PontshoMbizo/js06-gantry-robot/docs/images/C4_uncertainty_envelope.png

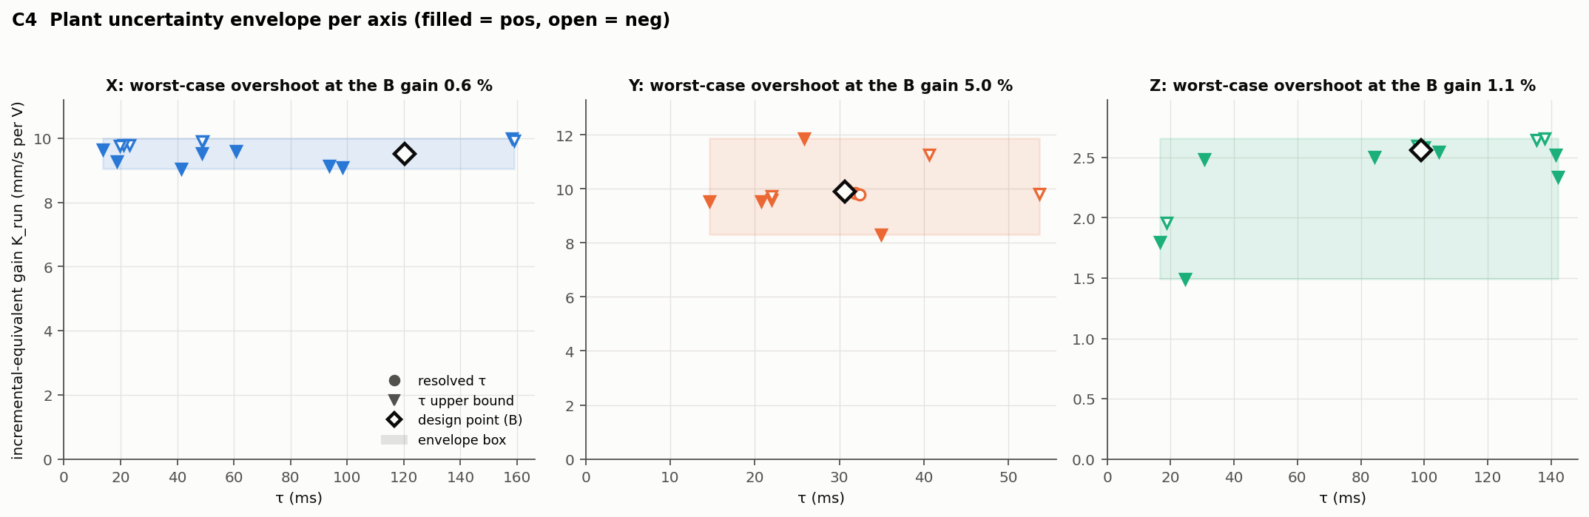
docs/images/C4_uncertainty_envelope.png
