PontshoMbizo/js06-gantry-robot/docs/images/gantry_built_photo.jpeg

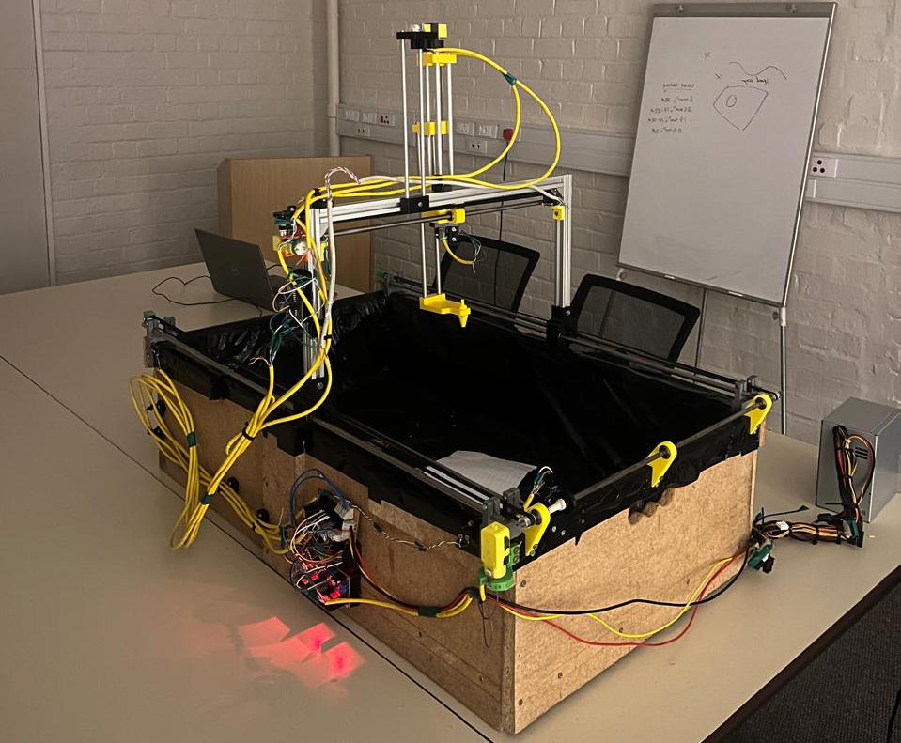
docs/images/gantry_built_photo.jpeg
