PontshoMbizo/js06-gantry-robot/docs/images/res_ctrl_settle.png

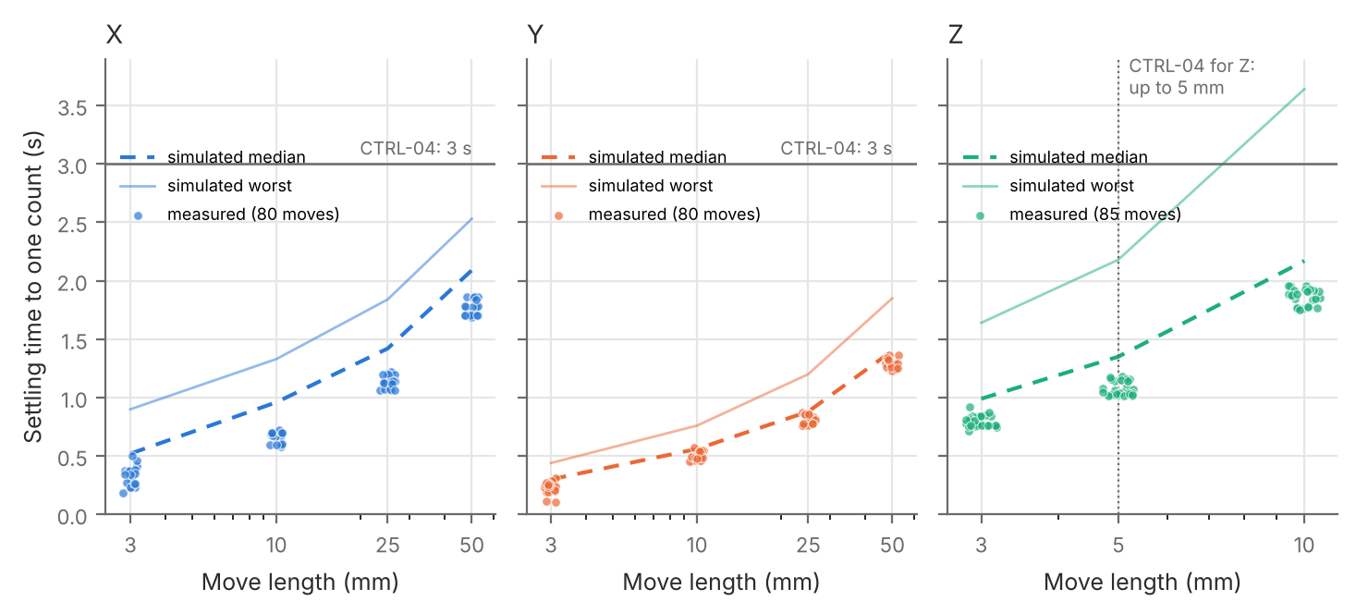
docs/images/res_ctrl_settle.png
