PontshoMbizo/js06-gantry-robot/simulation/ros2-digital-twin/src/main_gantry_assembly/meshes/__18.stl

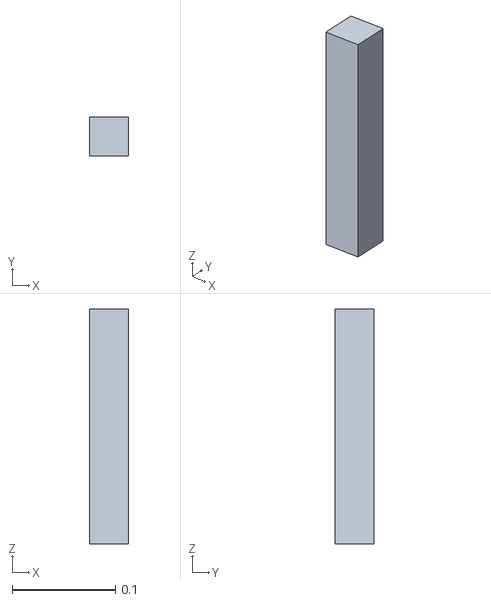
[picture p10: CAD file, 2026-11-06]
simulation/ros2-digital-twin/src/main_gantry_assembly/meshes/__18.stl
0.038 x 0.038 x 0.228
