PontshoMbizo/js06-gantry-robot/simulation/ros2-digital-twin/src/main_gantry_assembly/meshes/frame_holder.stl

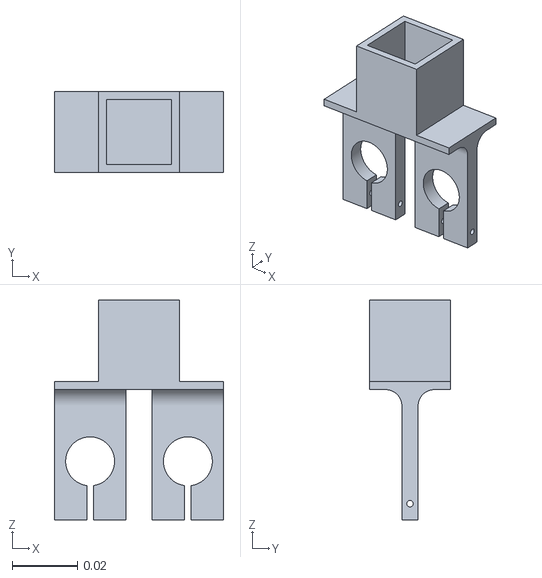
[picture p11: CAD file, 2026-11-06]
simulation/ros2-digital-twin/src/main_gantry_assembly/meshes/frame_holder.stl
0.052 x 0.025 x 0.0675
