PontshoMbizo/js06-gantry-robot/simulation/ros2-digital-twin/src/main_gantry_assembly/meshes/motor_holder.stl

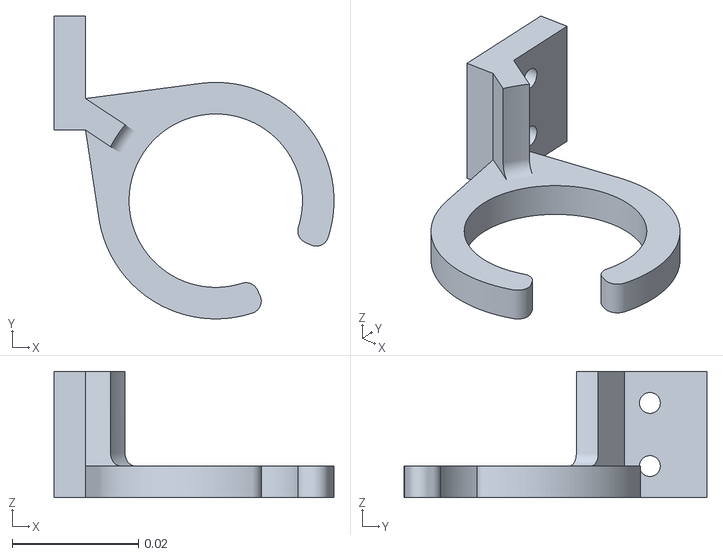
[picture p12: CAD file, 2026-11-06]
simulation/ros2-digital-twin/src/main_gantry_assembly/meshes/motor_holder.stl
0.0444 x 0.048 x 0.02
