PontshoMbizo/js06-gantry-robot/simulation/ros2-digital-twin/src/main_gantry_assembly/meshes/guide_holder_1.stl

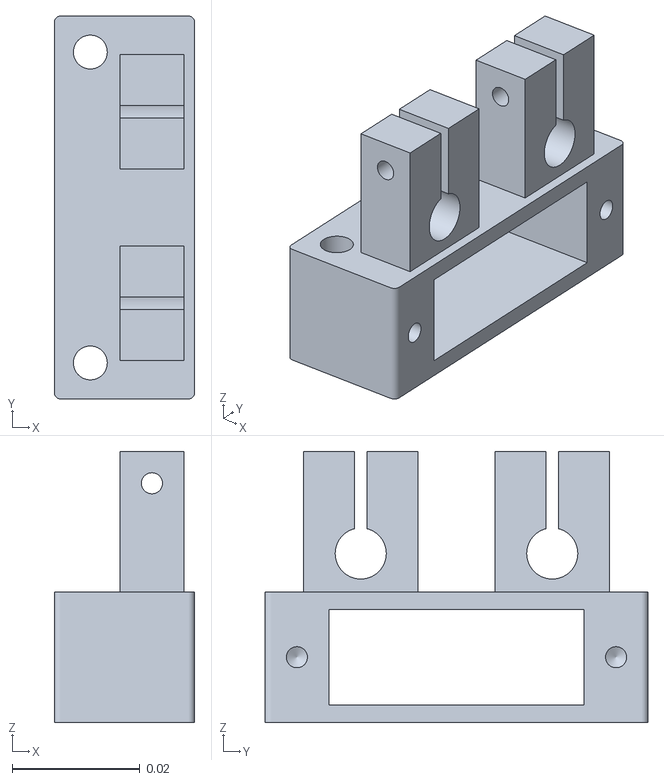
[picture p13: CAD file, 2026-11-06]
simulation/ros2-digital-twin/src/main_gantry_assembly/meshes/guide_holder_1.stl
0.022 x 0.06 x 0.0425
