PontshoMbizo/js06-gantry-robot/simulation/ros2-digital-twin/src/main_gantry_assembly/meshes/_8x1040_guide_rod.stl

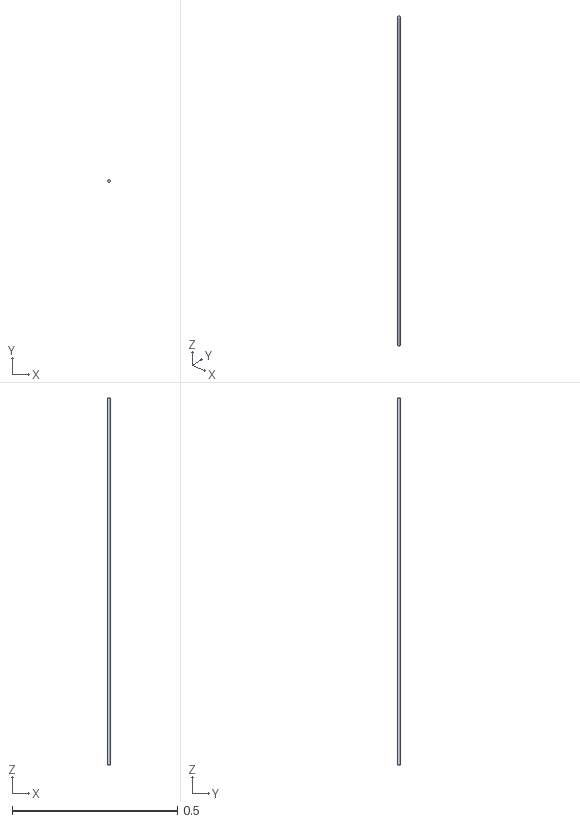
[picture p14: CAD file, 2026-11-06]
simulation/ros2-digital-twin/src/main_gantry_assembly/meshes/_8x1040_guide_rod.stl
0.008 x 0.008 x 1.11
