PontshoMbizo/js06-gantry-robot/simulation/ros2-digital-twin/src/main_gantry_assembly/meshes/shaft_extension.stl

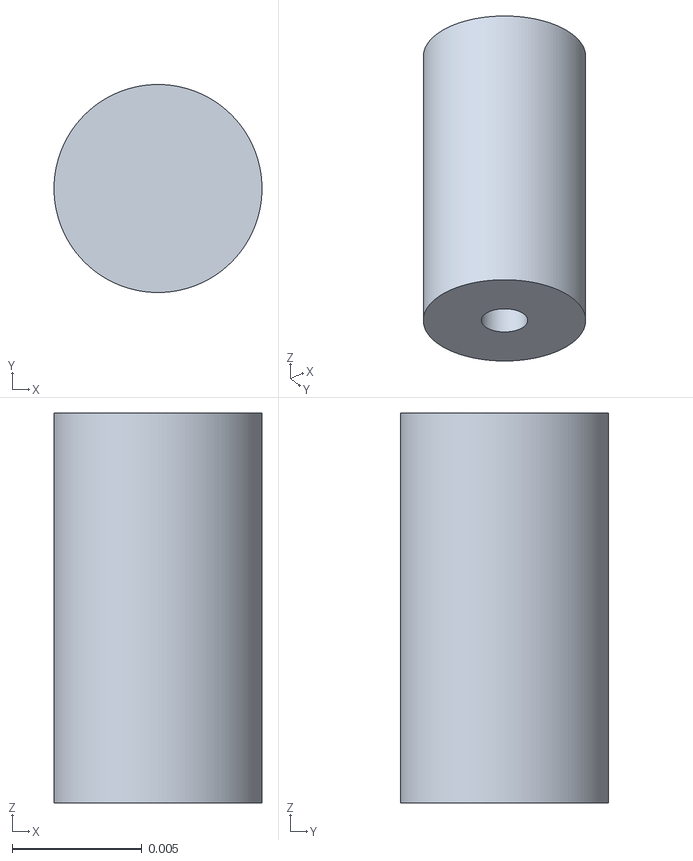
[picture p15: CAD file, 2026-11-06]
simulation/ros2-digital-twin/src/main_gantry_assembly/meshes/shaft_extension.stl
0.008 x 0.008 x 0.015
