PontshoMbizo/js06-gantry-robot/simulation/ros2-digital-twin/src/main_gantry_assembly/meshes/BokChoy__12_.stl

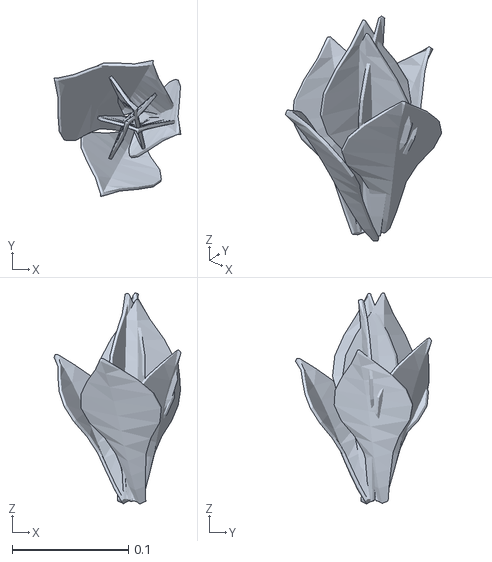
[picture p19: CAD file, 2026-11-06]
simulation/ros2-digital-twin/src/main_gantry_assembly/meshes/BokChoy__12_.stl
0.109 x 0.117 x 0.181
