PontshoMbizo/js06-gantry-robot/simulation/ros2-digital-twin/src/main_gantry_assembly/meshes/NICHIBO__MOTOR_BACK_01_Predeterminado__Fillet20.stl

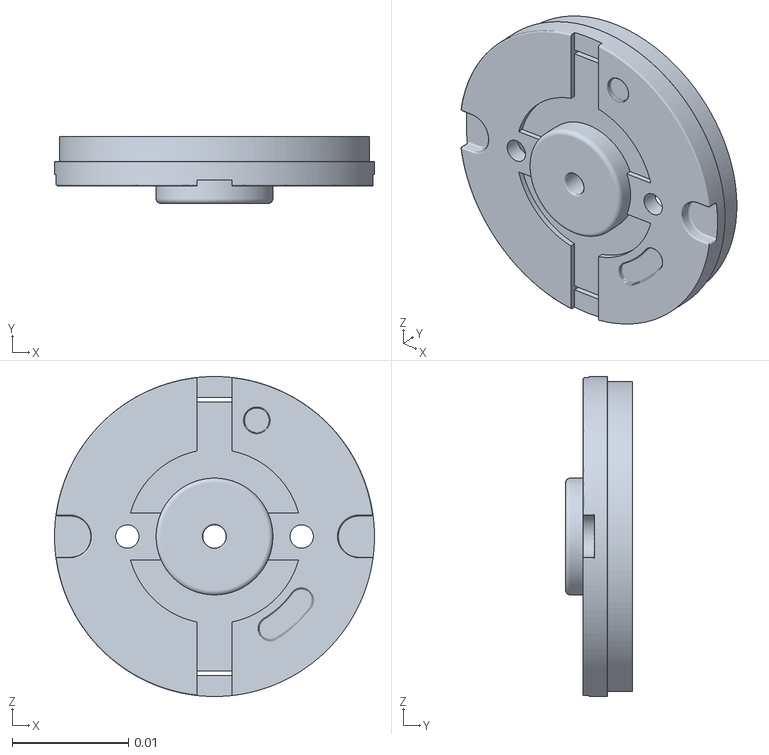
[picture p20: CAD file, 2026-11-06]
simulation/ros2-digital-twin/src/main_gantry_assembly/meshes/NICHIBO__MOTOR_BACK_01_Predeterminado__Fillet20.stl
0.0275 x 0.00574 x 0.0275
