PontshoMbizo/js06-gantry-robot/simulation/ros2-digital-twin/src/main_gantry_assembly/meshes/z_axis_end_piece.stl

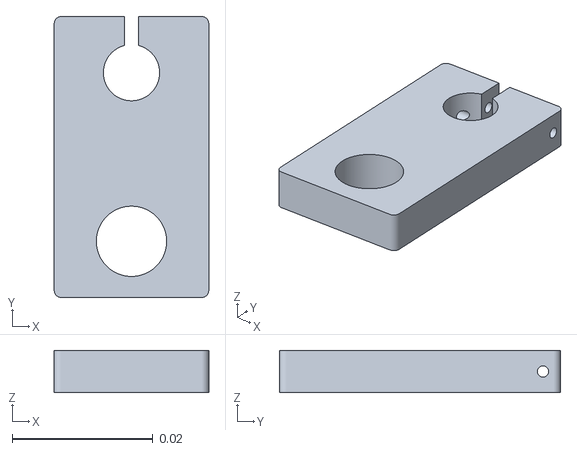
[picture p22: CAD file, 2026-11-06]
simulation/ros2-digital-twin/src/main_gantry_assembly/meshes/z_axis_end_piece.stl
0.022 x 0.04 x 0.006
