PontshoMbizo/js06-gantry-robot/simulation/ros2-digital-twin/src/main_gantry_assembly/meshes/COIL_01_Predeterminado__Fillet6.stl

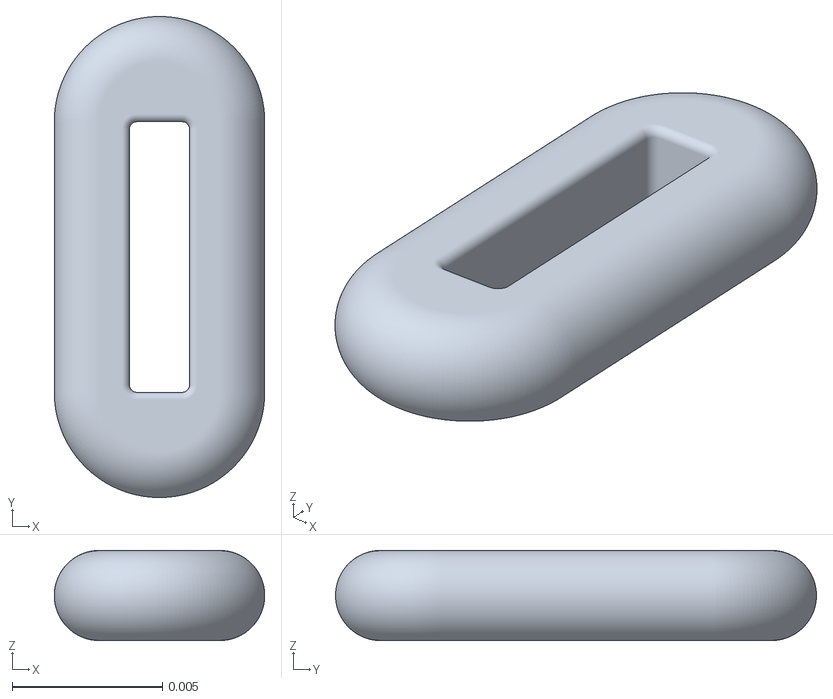
[picture p24: CAD file, 2026-11-06]
simulation/ros2-digital-twin/src/main_gantry_assembly/meshes/COIL_01_Predeterminado__Fillet6.stl
0.007 x 0.016 x 0.003
