PontshoMbizo/js06-gantry-robot/simulation/ros2-digital-twin/src/main_gantry_assembly/meshes/z_attachment.stl

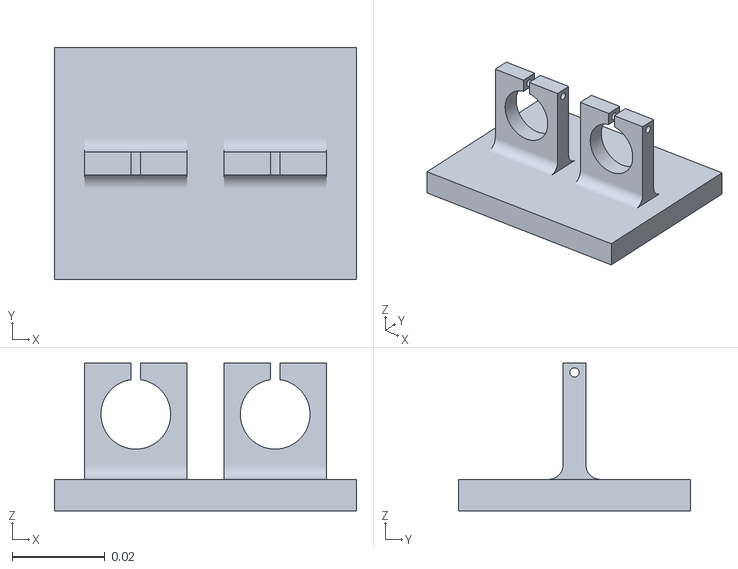
[picture p26: CAD file, 2026-11-06]
simulation/ros2-digital-twin/src/main_gantry_assembly/meshes/z_attachment.stl
0.065 x 0.05 x 0.0318
