PontshoMbizo/js06-gantry-robot/simulation/ros2-digital-twin/src/main_gantry_assembly/meshes/Lettuce__11_.stl

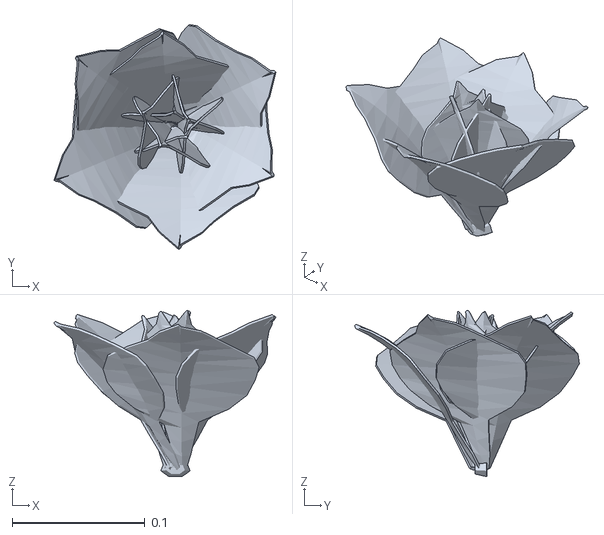
[picture p28: CAD file, 2026-11-06]
simulation/ros2-digital-twin/src/main_gantry_assembly/meshes/Lettuce__11_.stl
0.167 x 0.169 x 0.125
