PontshoMbizo/js06-gantry-robot/simulation/ros2-digital-twin/src/main_gantry_assembly/meshes/Default__SL_NZRCS3_2_8.stl

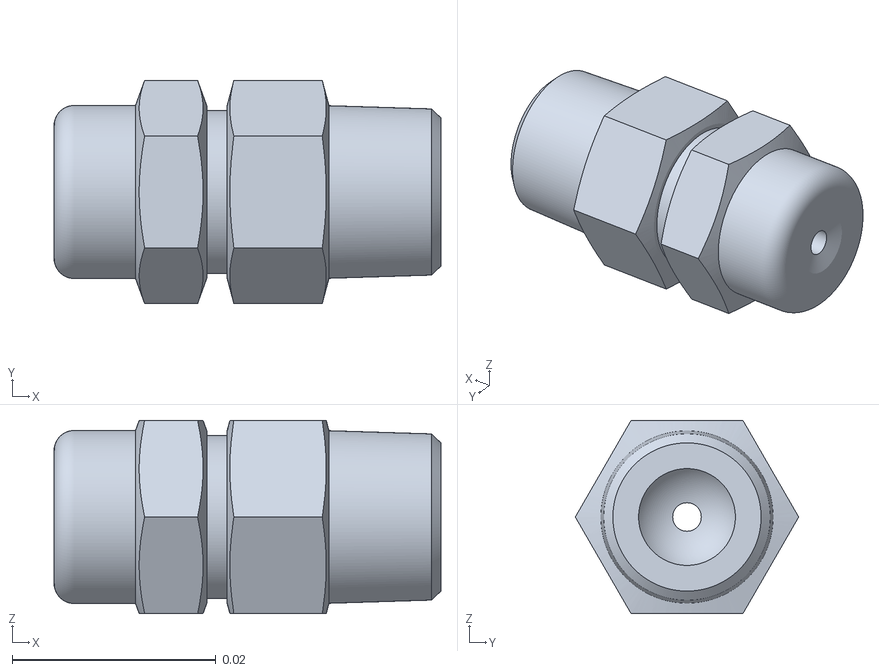
[picture p30: CAD file, 2026-11-06]
simulation/ros2-digital-twin/src/main_gantry_assembly/meshes/Default__SL_NZRCS3_2_8.stl
0.038 x 0.0219 x 0.019
