PontshoMbizo/js06-gantry-robot/simulation/ros2-digital-twin/src/main_gantry_assembly/meshes/gear_axis.stl

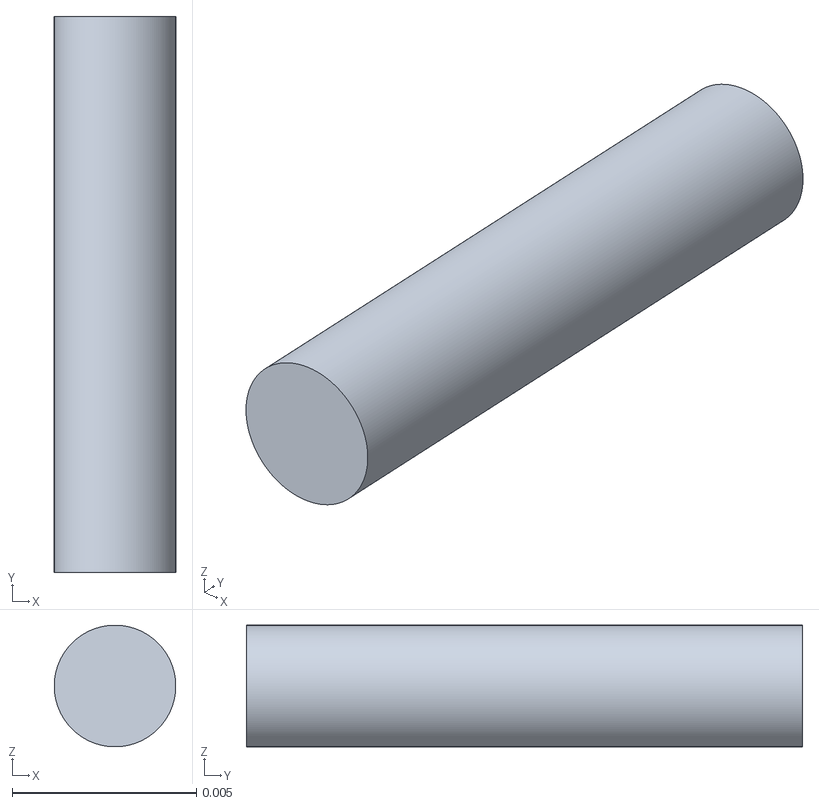
[picture p31: CAD file, 2026-11-06]
simulation/ros2-digital-twin/src/main_gantry_assembly/meshes/gear_axis.stl
0.0033 x 0.0151 x 0.0033
