PontshoMbizo/js06-gantry-robot/simulation/ros2-digital-twin/src/main_gantry_assembly/meshes/gear_idle_holder.stl

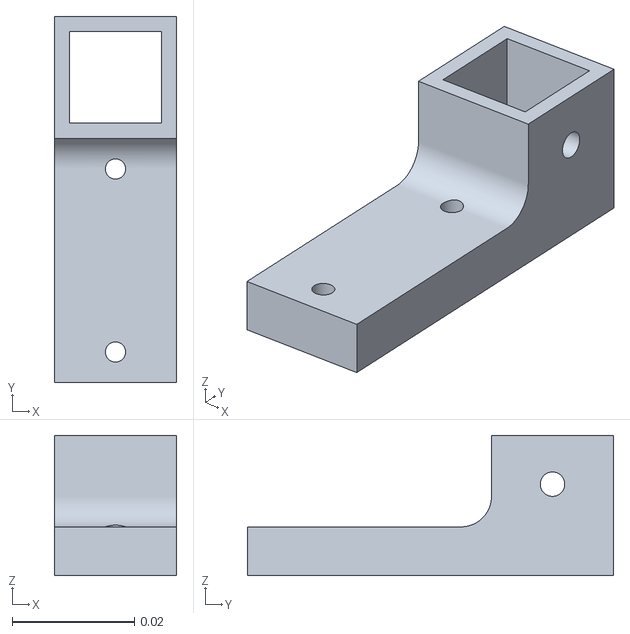
[picture p34: CAD file, 2026-11-06]
simulation/ros2-digital-twin/src/main_gantry_assembly/meshes/gear_idle_holder.stl
0.02 x 0.06 x 0.023
