PontshoMbizo/js06-gantry-robot/simulation/ros2-digital-twin/src/main_gantry_assembly/meshes/ARMATURE_NICHIBO_01_Predeterminado__Fillet5.stl

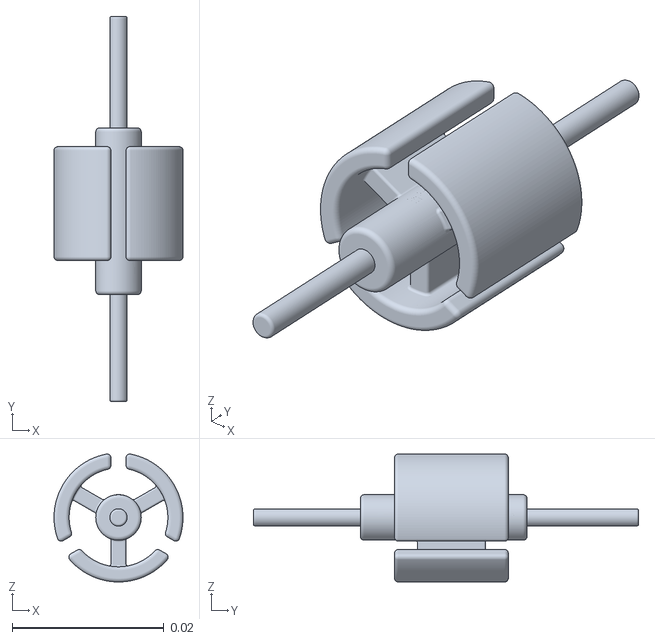
[picture p35: CAD file, 2026-11-06]
simulation/ros2-digital-twin/src/main_gantry_assembly/meshes/ARMATURE_NICHIBO_01_Predeterminado__Fillet5.stl
0.017 x 0.0508 x 0.0169
