PontshoMbizo/js06-gantry-robot/simulation/ros2-digital-twin/src/main_gantry_assembly/meshes/Radish__7_.stl

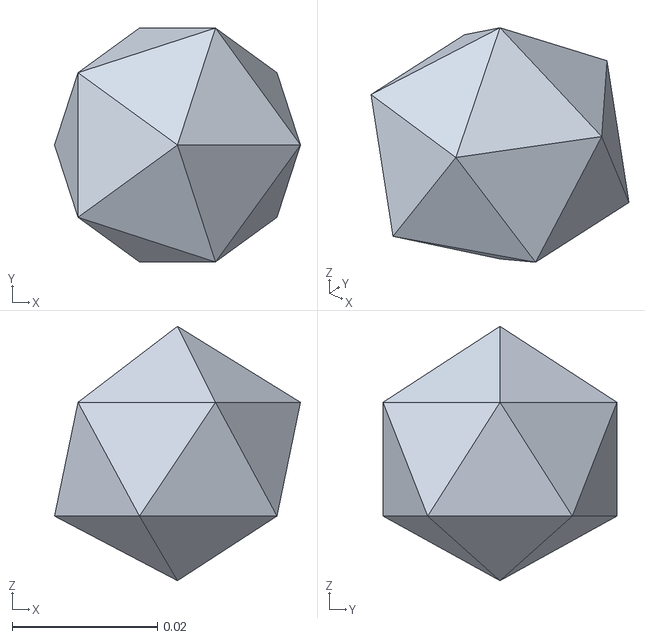
[picture p37: CAD file, 2026-11-06]
simulation/ros2-digital-twin/src/main_gantry_assembly/meshes/Radish__7_.stl
0.0339 x 0.0322 x 0.035
