PontshoMbizo/js06-gantry-robot/simulation/ros2-digital-twin/src/main_gantry_assembly/meshes/SoilCompartment.stl

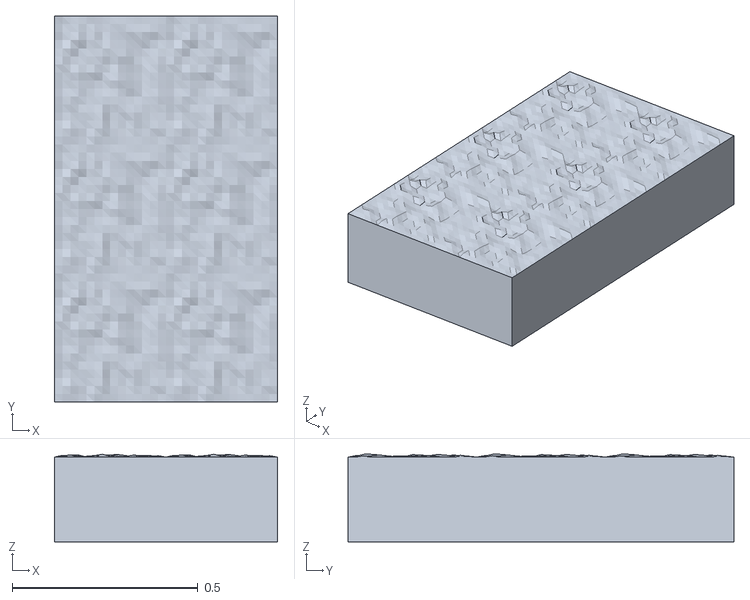
[picture p38: CAD file, 2026-11-06]
simulation/ros2-digital-twin/src/main_gantry_assembly/meshes/SoilCompartment.stl
0.6 x 1.04 x 0.236
