PontshoMbizo/js06-gantry-robot/simulation/ros2-digital-twin/src/main_gantry_assembly/meshes/NICHIBO_MOTOR_HOUSING_01_Predeterminado__Cut_Extrude10.stl

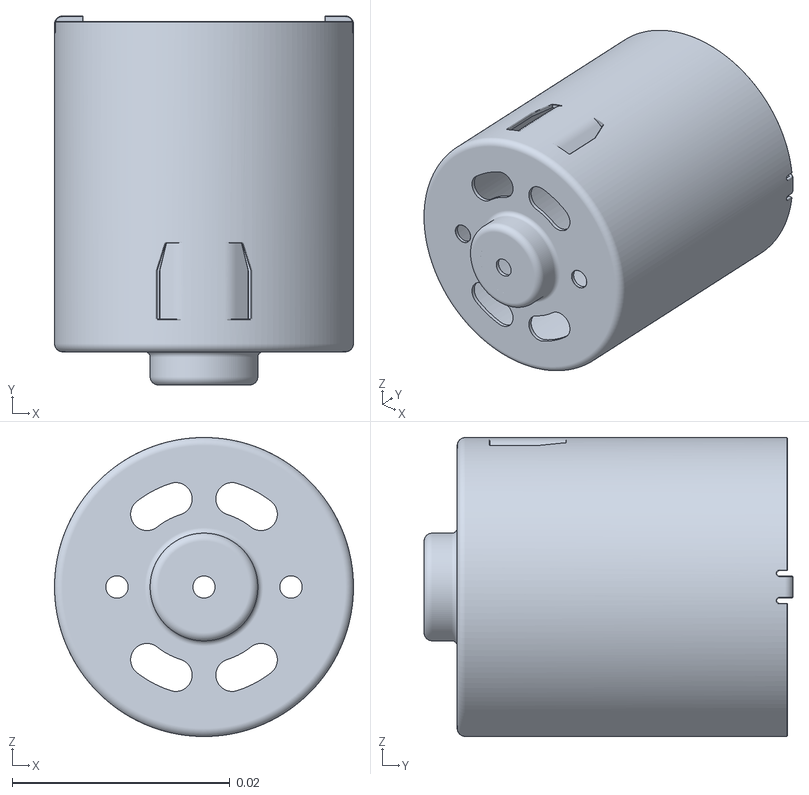
[picture p39: CAD file, 2026-11-06]
simulation/ros2-digital-twin/src/main_gantry_assembly/meshes/NICHIBO_MOTOR_HOUSING_01_Predeterminado__Cut_Extrude10.stl
0.0275 x 0.0339 x 0.0275
