PontshoMbizo/js06-gantry-robot/simulation/ros2-digital-twin/src/main_gantry_assembly/meshes/_618_5x8_tappered_3_85x4_coupling_rod.stl

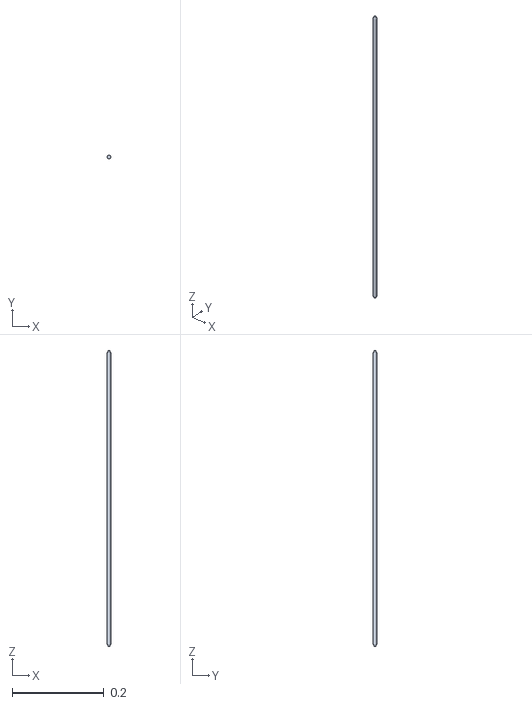
[picture p40: CAD file, 2026-11-06]
simulation/ros2-digital-twin/src/main_gantry_assembly/meshes/_618_5x8_tappered_3_85x4_coupling_rod.stl
0.008 x 0.008 x 0.644
