PontshoMbizo/js06-gantry-robot/simulation/ros2-digital-twin/src/main_gantry_assembly/meshes/nozzle_part.stl

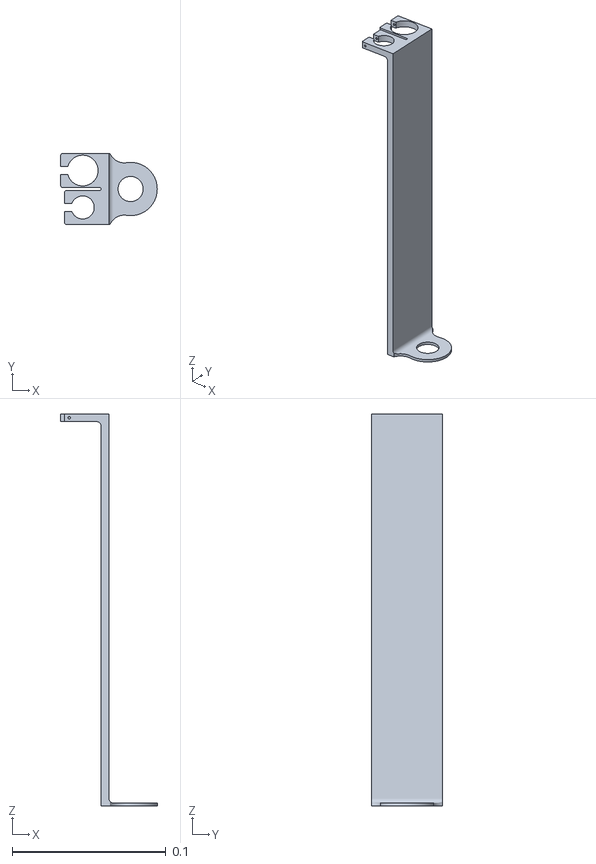
[picture p41: CAD file, 2026-11-06]
simulation/ros2-digital-twin/src/main_gantry_assembly/meshes/nozzle_part.stl
0.0628 x 0.046 x 0.255
