PontshoMbizo/js06-gantry-robot/simulation/ros2-digital-twin/src/main_gantry_assembly/meshes/_8x270_guide.stl

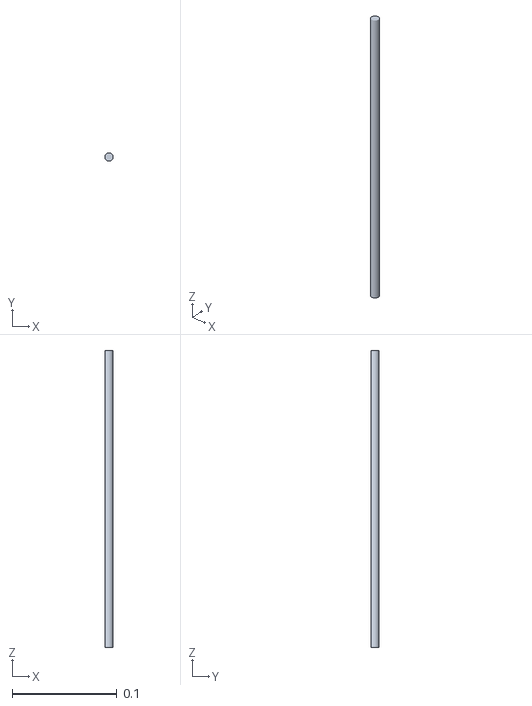
[picture p42: CAD file, 2026-11-06]
simulation/ros2-digital-twin/src/main_gantry_assembly/meshes/_8x270_guide.stl
0.008 x 0.008 x 0.284
