PontshoMbizo/js06-gantry-robot/simulation/ros2-digital-twin/src/main_gantry_assembly/meshes/control_box_lid.stl

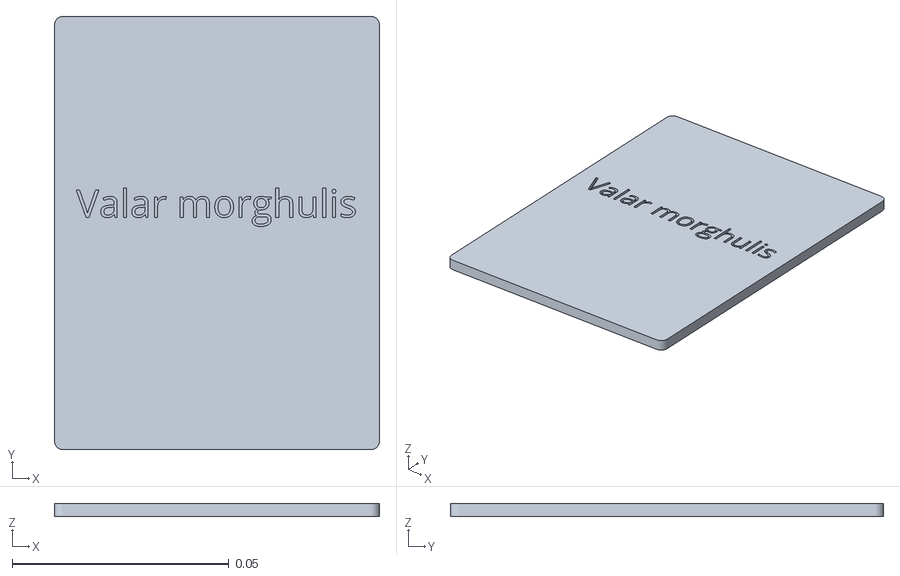
[picture p44: CAD file, 2026-11-06]
simulation/ros2-digital-twin/src/main_gantry_assembly/meshes/control_box_lid.stl
0.075 x 0.1 x 0.003
