PontshoMbizo/js06-gantry-robot/simulation/ros2-digital-twin/src/main_gantry_assembly/meshes/Terminal3V_Predeterminado__Fillet3.stl

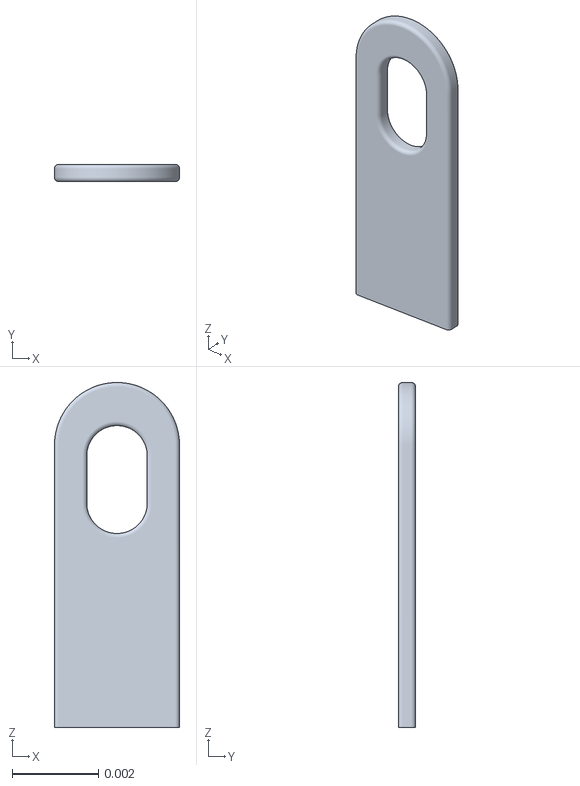
[picture p46: CAD file, 2026-11-06]
simulation/ros2-digital-twin/src/main_gantry_assembly/meshes/Terminal3V_Predeterminado__Fillet3.stl
0.0029 x 0.0004 x 0.008
