PontshoMbizo/js06-gantry-robot/simulation/ros2-digital-twin/src/main_gantry_assembly/meshes/gear_idler_holder.stl

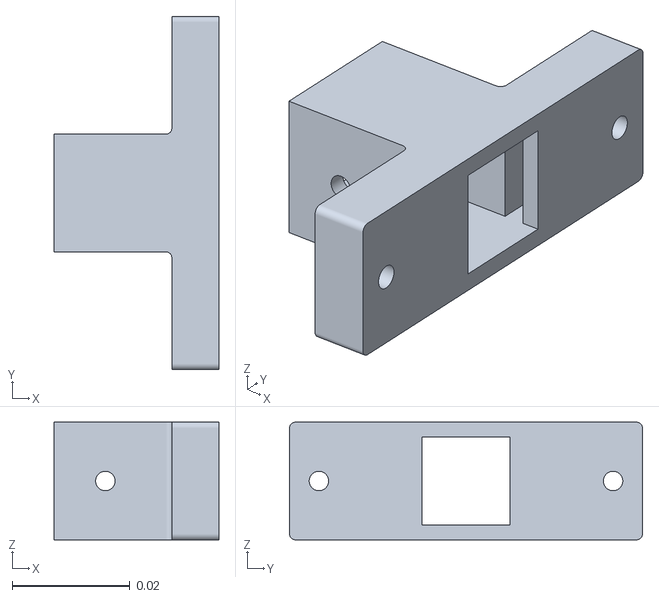
[picture p47: CAD file, 2026-11-06]
simulation/ros2-digital-twin/src/main_gantry_assembly/meshes/gear_idler_holder.stl
0.028 x 0.06 x 0.02
