PontshoMbizo/js06-gantry-robot/simulation/ros2-digital-twin/src/main_gantry_assembly/meshes/Default__SUTB106A4ZZ.stl

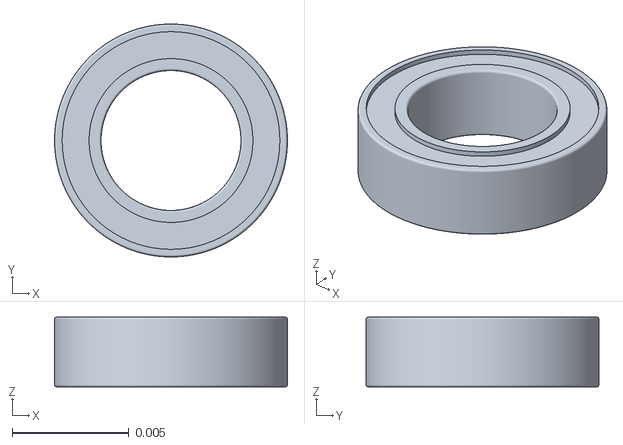
[picture p48: CAD file, 2026-11-06]
simulation/ros2-digital-twin/src/main_gantry_assembly/meshes/Default__SUTB106A4ZZ.stl
0.01 x 0.01 x 0.003
