PontshoMbizo/js06-gantry-robot/simulation/ros2-digital-twin/src/main_gantry_assembly/meshes/z_axis_motor_support.stl

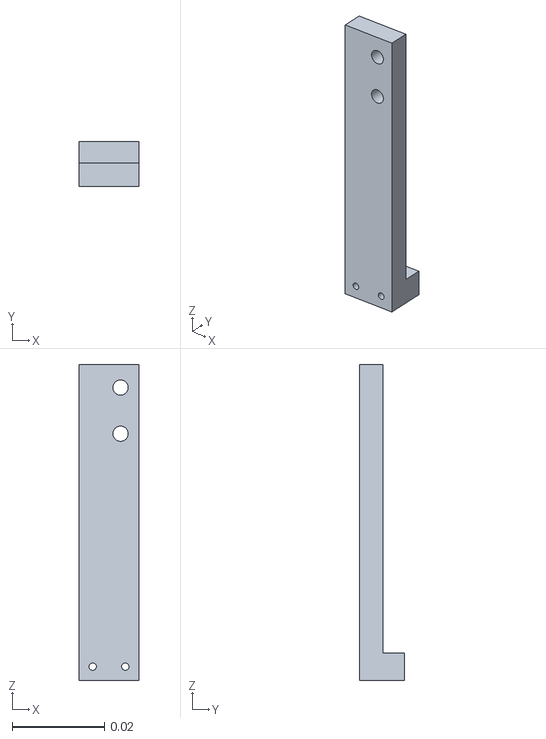
[picture p49: CAD file, 2026-11-06]
simulation/ros2-digital-twin/src/main_gantry_assembly/meshes/z_axis_motor_support.stl
0.0131 x 0.00965 x 0.0685
