PontshoMbizo/js06-gantry-robot/simulation/ros2-digital-twin/src/main_gantry_assembly/meshes/motor_bracket.stl

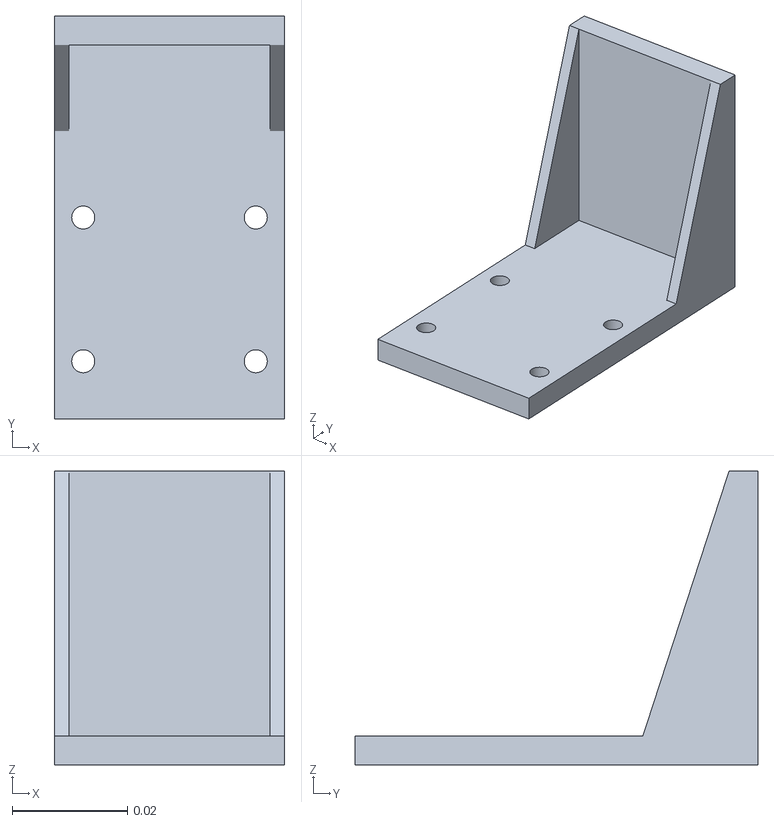
[picture p50: CAD file, 2026-11-06]
simulation/ros2-digital-twin/src/main_gantry_assembly/meshes/motor_bracket.stl
0.04 x 0.07 x 0.0511
