PontshoMbizo/js06-gantry-robot/simulation/ros2-digital-twin/src/main_gantry_assembly/meshes/Radish__4_.stl

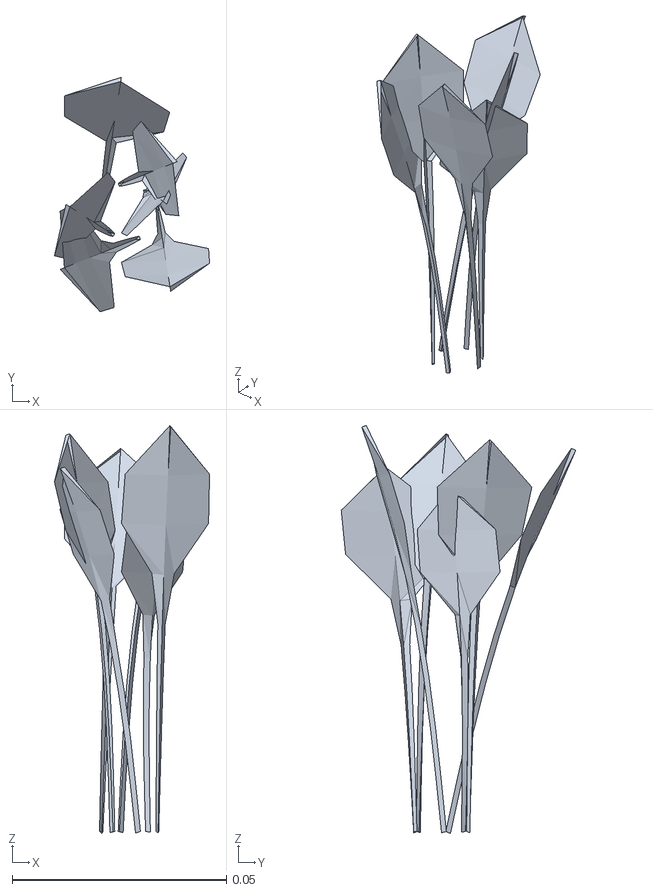
[picture p51: CAD file, 2026-11-06]
simulation/ros2-digital-twin/src/main_gantry_assembly/meshes/Radish__4_.stl
0.0362 x 0.0547 x 0.0951
