PontshoMbizo/js06-gantry-robot/simulation/ros2-digital-twin/src/main_gantry_assembly/meshes/Default__CPLCN20_8_8_b.stl

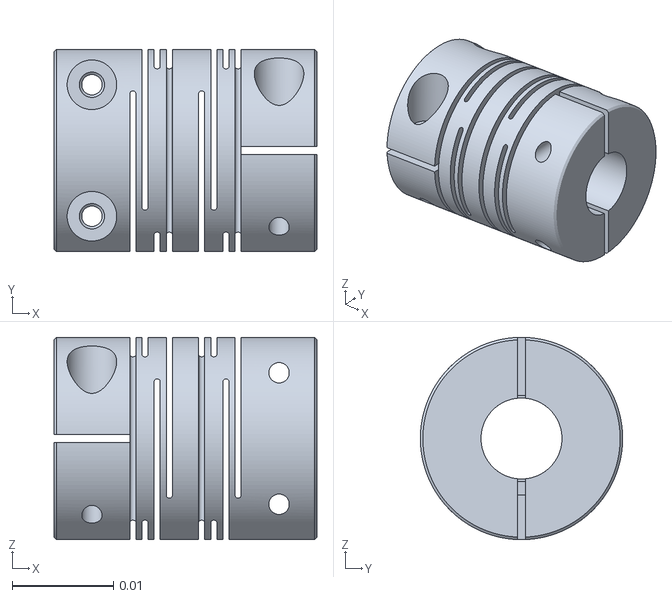
[picture p52: CAD file, 2026-11-06]
simulation/ros2-digital-twin/src/main_gantry_assembly/meshes/Default__CPLCN20_8_8_b.stl
0.026 x 0.02 x 0.02
