PontshoMbizo/js06-gantry-robot/(list of files, cad)

Other CAD files:
simulation/ros2-digital-twin/src/main_gantry_assembly/meshes/__1.stl
simulation/ros2-digital-twin/src/main_gantry_assembly/meshes/_.stl
simulation/ros2-digital-twin/src/main_gantry_assembly/meshes/__15.stl
simulation/ros2-digital-twin/src/main_gantry_assembly/meshes/__10.stl
simulation/ros2-digital-twin/src/main_gantry_assembly/meshes/__16.stl
simulation/ros2-digital-twin/src/main_gantry_assembly/meshes/__19.stl
simulation/ros2-digital-twin/src/main_gantry_assembly/meshes/__5.stl
simulation/ros2-digital-twin/src/main_gantry_assembly/meshes/__6.stl
simulation/ros2-digital-twin/src/main_gantry_assembly/meshes/__9.stl
simulation/ros2-digital-twin/src/main_gantry_assembly/meshes/__8.stl
simulation/ros2-digital-twin/src/main_gantry_assembly/meshes/__2.stl
simulation/ros2-digital-twin/src/main_gantry_assembly/meshes/__12.stl
simulation/ros2-digital-twin/src/main_gantry_assembly/meshes/__4.stl
simulation/ros2-digital-twin/src/main_gantry_assembly/meshes/__11.stl
simulation/ros2-digital-twin/src/main_gantry_assembly/meshes/__17.stl
simulation/ros2-digital-twin/src/main_gantry_assembly/meshes/_8x270x1_5_lead_screw.stl
