PontshoMbizo/js06-gantry-robot/simulation/ros2-digital-twin/src/main_gantry_assembly/urdf/main_assembly.urdf

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
<robot name="main_assembly">
    <link name="618_5x8_tappered_3_85x4_coupling_rod">
        <inertial>
            <mass value="3.20656e-05" />
            <origin xyz="0 -1.22095e-19 -0.32185" rpy="0 -0 0" />
            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
        </inertial>
        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
    </link>
    <link name="8x1040_guide_rod">
        <inertial>
            <mass value="5.57444e-05" />
            <origin xyz="2.77556e-17 -1.92593e-34 -0.5545" rpy="0 -0 0" />
            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
        </inertial>
        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
    </link>
    <link name="8x1040_guide_rod_1">
        <inertial>
            <mass value="5.57444e-05" />
            <origin xyz="2.77556e-17 -1.44445e-34 0.5545" rpy="0 -0 0" />
            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
        </inertial>
        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
    </link>
    <link name="8x1040_guide_rod_2">
        <inertial>
            <mass value="5.57444e-05" />
            <origin xyz="2.77556e-17 -1.92593e-34 -0.5545" rpy="0 -0 0" />
            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
        </inertial>
        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
    </link>
    <link name="8x1040_guide_rod_3">
        <inertial>
            <mass value="5.57444e-05" />
            <origin xyz="2.77556e-17 -1.44445e-34 0.5545" rpy="0 -0 0" />
            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
        </inertial>
        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
    </link>
    <link name="8x270_guide">
        <inertial>
            <mass value="1.42754e-05" />
            <origin xyz="1.85336e-19 -1.44445e-34 0.142" rpy="0 -0 0" />
            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
        </inertial>
        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
    </link>
    <link name="8x270x1_5_lead_screw">
        <inertial>
            <mass value="2.32164e-05" />
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
        </inertial>
        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
    </link>
    <link name="default__cplcn20_8_8_b">
        <inertial>
            <mass value="0.00640527" />
            <origin xyz="0.0013 -0.00015552 -0.00015552" rpy="0 -0 0" />
            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
        </inertial>
        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
    </link>
    <link name="default__cplcn20_8_8_b_1">
        <inertial>
            <mass value="0.00640527" />
            <origin xyz="0.0019 -0.00015552 -0.00015552" rpy="0 -0 0" />
            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
        </inertial>
        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
    </link>
    <link name="default__cplcn20_8_8_b_2">
        <inertial>
            <mass value="0.00640527" />
            <origin xyz="-0.013 -0.00015552 -0.00015552" rpy="0 -0 0" />
            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
        </inertial>
        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
    </link>
    <link name="default__sl_nzrcs3_2_8">
        <inertial>
            <mass value="6.70002e-06" />
            <origin xyz="0.00110206 -3.10162e-18 -2.71322e-19" rpy="0 -0 0" />
            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
        </inertial>
        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
    </link>
    <link name="default__sutb106a4zz">
        <inertial>
            <mass value="1.38701e-07" />
            <origin xyz="1.95262e-19 2.38551e-19 -0.0014" rpy="0 -0 0" />
            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
        </inertial>
        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
    </link>
    <link name="default__sutb106a4zz_1">
        <inertial>
            <mass value="1.38701e-07" />
            <origin xyz="1.95262e-19 2.38551e-19 -0.0014" rpy="0 -0 0" />
            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
        </inertial>
        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
    </link>
    <link name="dof_lead_nut" />
    <link name="fix_end_piece" />
    <link name="fix_end_piece_1" />
    <link name="fix_end_piece_2" />
    <link name="fix_support" />
    <link name="fix_support_1" />
    <link name="fix_support_2" />
    <link name="frame_holder">
        <inertial>
            <mass value="0.0213048" />
            <origin xyz="-0.015 -6.93889e-18 0.0200196" rpy="0 -0 0" />
            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
        </inertial>
        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
    </link>
    <link name="frame_holder_1">
        <inertial>
            <mass value="0.0213048" />
            <origin xyz="-0.015 -6.93889e-18 0.0200196" rpy="0 -0 0" />
            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
        </inertial>
        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
    </link>
    <link name="frame_holder__1__loop_closure">
        <inertial>
            <mass value="1e-09" />
            <origin xyz="0 0 0" rpy="0 -0 0" />
            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
        </inertial>
    </link>
    <link name="gear_axis">
        <inertial>
            <mass value="1.2915e-07" />
            <origin xyz="1.66533e-16 0.00755 -1.73472e-18" rpy="0 -0 0" />
            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
        </inertial>
        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
    </link>
    <link name="gear_axis_1">
        <inertial>
            <mass value="1.2915e-07" />
            <origin xyz="1.66533e-16 0.00755 -3.46945e-18" rpy="0 -0 0" />
            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
        </inertial>
        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
    </link>
    <link name="gear_idle_holder">
        <inertial>
            <mass value="0.0129154" />
            <origin xyz="-1.1938e-14 0.0316998 0.00690779" rpy="0 -0 0" />
            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
        </inertial>
        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
    </link>
    <link name="gear_idle_holder_1">
        <inertial>
            <mass value="0.0129154" />
            <origin xyz="-1.19258e-14 -0.00330017 0.00690779" rpy="0 -0 0" />
            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
        </inertial>
        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
    </link>
    <link name="gear_idle_holder_2">
        <inertial>
            <mass value="0.0129154" />
            <origin xyz="-1.1938e-14 0.0316998 0.00690779" rpy="0 -0 0" />
            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
        </inertial>
        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
    </link>
    <link name="gear_idle_holder_3">
        <inertial>
            <mass value="0.0129154" />
            <origin xyz="-1.19258e-14 -0.00330017 0.00690779" rpy="0 -0 0" />
            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
        </inertial>
        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
    </link>
    <link name="gear_idler_holder">
        <inertial>
            <mass value="0.0117168" />
            <origin xyz="-0.00916163 0.025 0" rpy="0 -0 0" />
            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
        </inertial>
        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
    </link>
    <link name="gear_idler_holder_1">
        <inertial>
            <mass value="0.0117168" />
            <origin xyz="-0.00916163 0.025 0" rpy="0 -0 0" />
            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
        </inertial>
        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
    </link>
    <link name="guide_holder">
        <inertial>
            <mass value="0.0241753" />
            <origin xyz="2.77556e-17 0.01 0.00522515" rpy="0 -0 0" />
            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
        </inertial>
        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
    </link>
    <link name="guide_holder_1">
        <inertial>
            <mass value="0.0241753" />
            <origin xyz="0.015 0.004 -0.00977485" rpy="0 -0 0" />
            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
        </inertial>
        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
    </link>
    <link name="guide_holder_2">
        <inertial>
            <mass value="0.0235401" />
            <origin xyz="0.00697448 0.02435 0.0172525" rpy="0 -0 0" />
            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
        </inertial>
        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
    </link>
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
        <inertial>
            <mass value="5.95257e-05" />
            <origin xyz="1.9581e-19 -5.40965e-20 0.00353066" rpy="0 -0 0" />
            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
        </inertial>
        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
    </link>
    <link name="terminal3v_predeterminado__fillet3_2">
        <inertial>
            <mass value="5.95257e-05" />
            <origin xyz="1.9581e-19 -5.40965e-20 0.00353066" rpy="0 -0 0" />
            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
        </inertial>
        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
    </link>
    <link name="terminal3v_predeterminado__fillet3_3">
        <inertial>
            <mass value="5.95257e-05" />
            <origin xyz="1.9581e-19 -5.40965e-20 0.00353066" rpy="0 -0 0" />
            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
        </inertial>
        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
    </link>
    <link name="terminal3v_predeterminado__fillet3_4">
        <inertial>
            <mass value="5.95257e-05" />
            <origin xyz="1.9581e-19 -5.40965e-20 0.00353066" rpy="0 -0 0" />
            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
        </inertial>
        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
    </link>
    <link name="terminal3v_predeterminado__fillet3_5">
        <inertial>
            <mass value="5.95257e-05" />
            <origin xyz="1.9581e-19 -5.40965e-20 0.00353066" rpy="0 -0 0" />
            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
        </inertial>
        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
    </link>
    <link name="terminal3v_predeterminado__fillet3__2__loop_closure">
        <inertial>
            <mass value="1e-09" />
            <origin xyz="0 0 0" rpy="0 -0 0" />
            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
        </inertial>
    </link>
    <link name="x_carriage__1_" />
    <link name="y_carriage__1_" />
    <link name="z_attachment">
        <inertial>
            <mass value="0.0322584" />
            <origin xyz="0.015 -8.81456e-20 -0.0153773" rpy="0 -0 0" />
            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
        </inertial>
        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
    </link>
    <link name="z_axis_carriage_piece__1_" />
    <link name="z_axis_end_piece">
        <inertial>
            <mass value="0.00547166" />
            <origin xyz="-0.0109471 0.000176597 5.5544e-06" rpy="0 -0 0" />
            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
        </inertial>
        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
    </link>
    <link name="z_axis_end_piece_1">
        <inertial>
            <mass value="0.00547166" />
            <origin xyz="5.29383e-05 -0.0119791 -0.00299445" rpy="0 -0 0" />
            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
        </inertial>
        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
    </link>
    <link name="z_axis_end_piece__1__loop_closure">
        <inertial>
            <mass value="1e-09" />
            <origin xyz="0 0 0" rpy="0 -0 0" />
            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
        </inertial>
    </link>
    <link name="z_axis_motor_support">
        <inertial>
            <mass value="4.71205e-06" />
            <origin xyz="-0.0227639 -0.0177915 -0.0368325" rpy="0 -0 0" />
            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
        </inertial>
        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
    </link>
    <joint name="bok_choy__3__fastened_joint" type="fixed">
        <origin xyz="0 0 0" rpy="0 0 -8.95218e-100" />
        <axis xyz="0 0 1" />
        <parent link="bokchoy__12__5" />
        <child link="composite_part_1__15_" />
    </joint>
    <joint name="bok_choy__3__fastened_joint_1" type="fixed">
        <origin xyz="0 -0.16 -5.55112e-17" rpy="0 0 -8.95218e-100" />
        <axis xyz="-0 -0 -1" />
        <parent link="bokchoy__12_" />
        <child link="bokchoy__12__1" />
    </joint>
    <joint name="bok_choy__3__fastened_joint_2" type="fixed">
        <origin xyz="1.11022e-16 -0.16 0" rpy="0 0 -8.95218e-100" />
        <axis xyz="0 0 1" />
        <parent link="bokchoy__12__5" />
        <child link="composite_part_1__16_" />
    </joint>
    <joint name="bok_choy__3__fastened_joint_3" type="fixed">
        <origin xyz="1.11022e-16 -0.48 -5.55112e-17" rpy="0 0 -8.95218e-100" />
        <axis xyz="-0 -0 -1" />
        <parent link="bokchoy__12_" />
        <child link="bokchoy__12__4" />
    </joint>
    <joint name="bok_choy__3__fastened_joint_4" type="fixed">
        <origin xyz="0 0 0" rpy="0 0 -8.95218e-100" />
        <axis xyz="-0 -0 -1" />
        <parent link="bokchoy__12_" />
        <child link="composite_part_2__3_" />
    </joint>
    <joint name="bok_choy__3__fastened_joint_5" type="fixed">
        <origin xyz="0 0.16 0" rpy="0 0 -8.95218e-100" />
        <axis xyz="0 0 1" />
        <parent link="bokchoy__12__5" />
        <child link="composite_part_1__9_" />
    </joint>
    <joint name="bok_choy__3__fastened_joint_6" type="fixed">
        <origin xyz="0 0.32 5.55112e-17" rpy="0 0 -8.95218e-100" />
        <axis xyz="0 0 1" />
        <parent link="bokchoy__12__5" />
        <child link="bokchoy__12_" />
    </joint>
    <joint name="bok_choy__3__fastened_joint_loop_closure" type="fixed">
        <origin xyz="-1.11022e-16 0.32 0" rpy="0 0 -8.95218e-100" />
        <axis xyz="-0 -0 -1" />
        <parent link="composite_part_1__16_" />
        <child link="composite_part_2__6__loop_closure" />
    </joint>
    <joint name="bok_choy__3__fastened_joint_loop_closure_1" type="fixed">
        <origin xyz="0 0 0" rpy="0 0 -8.95218e-100" />
        <axis xyz="-0 -0 -1" />
        <parent link="composite_part_1__16_" />
        <child link="composite_part_2__8__loop_closure" />
    </joint>
    <joint name="bok_choy__3__fastened_joint_loop_closure_2" type="fixed">
        <origin xyz="-1.11022e-16 0.48 5.55112e-17" rpy="0 0 -8.95218e-100" />
        <axis xyz="-0 -0 -1" />
        <parent link="composite_part_1__16_" />
        <child link="composite_part_2__3__loop_closure" />
    </joint>
    <joint name="bok_choy__4__fastened_joint" type="fixed">
        <origin xyz="2.77556e-17 -0.16 5.55112e-17" rpy="0 0 -8.95218e-100" />
        <axis xyz="-0 -0 -1" />
        <parent link="bokchoy__12__7" />
        <child link="bokchoy__12__2" />
    </joint>
    <joint name="bok_choy__4__fastened_joint_1" type="fixed">
        <origin xyz="0 0 0" rpy="0 0 -8.95218e-100" />
        <axis xyz="0 0 1" />
        <parent link="composite_part_2__4_" />
        <child link="bokchoy__12__6" />
    </joint>
    <joint name="bok_choy__4__fastened_joint_2" type="fixed">
        <origin xyz="5.55112e-17 -0.32 5.55112e-17" rpy="0 0 -8.95218e-100" />
        <axis xyz="-0 -0 -1" />
        <parent link="bokchoy__12__7" />
        <child link="bokchoy__12__3" />
    </joint>
    <joint name="bok_choy__4__fastened_joint_3" type="fixed">
        <origin xyz="0 0 0" rpy="0 0 -8.95218e-100" />
        <axis xyz="-0 -0 -1" />
        <parent link="bokchoy__12__7" />
        <child link="composite_part_2__1_" />
    </joint>
    <joint name="bok_choy__4__fastened_joint_4" type="fixed">
        <origin xyz="-5.55112e-17 0.16 0" rpy="0 0 -8.95218e-100" />
        <axis xyz="-0 -0 -1" />
        <parent link="bokchoy__12__7" />
        <child link="composite_part_2__4_" />
    </joint>
    <joint name="bok_choy__4__fastened_joint_5" type="fixed">
        <origin xyz="8.32667e-17 -0.32 5.55112e-17" rpy="0 0 -8.95218e-100" />
        <axis xyz="0 0 1" />
        <parent link="composite_part_2__4_" />
        <child link="composite_part_1__4_" />
    </joint>
    <joint name="bok_choy__4__fastened_joint_6" type="fixed">
        <origin xyz="1.11022e-16 -0.48 5.55112e-17" rpy="0 0 -8.95218e-100" />
        <axis xyz="0 0 1" />
        <parent link="composite_part_2__4_" />
        <child link="composite_part_1__8_" />
    </joint>
    <joint name="bok_choy__4__fastened_joint_loop_closure" type="fixed">
        <origin xyz="-1.11022e-16 0.48 -5.55112e-17" rpy="0 0 -8.95218e-100" />
        <axis xyz="0 0 1" />
        <parent link="bokchoy__12__3" />
        <child link="composite_part_1__7__loop_closure" />
    </joint>
    <joint name="bok_choy__4__fastened_joint_loop_closure_1" type="fixed">
        <origin xyz="-2.77556e-17 0.16 0" rpy="0 0 -8.95218e-100" />
        <axis xyz="0 0 1" />
        <parent link="bokchoy__12__3" />
        <child link="composite_part_1__4__loop_closure" />
    </joint>
    <joint name="bok_choy__4__fastened_joint_loop_closure_2" type="fixed">
        <origin xyz="0 0 0" rpy="0 0 -8.95218e-100" />
        <axis xyz="0 0 1" />
        <parent link="bokchoy__12__3" />
        <child link="composite_part_1__8__loop_closure" />
    </joint>
    <joint name="dof_armature" type="continuous">
        <origin xyz="3.84415e-15 0.0508 2.9976e-15" rpy="8.11008e-16 -0.587307 3.14159" />
        <axis xyz="0 -1 0" />
        <parent link="armature_nichibo_01_predeterminado__fillet5_2" />
        <child link="nichibo__motor_back_01_predeterminado__fillet20_2" />
    </joint>
    <joint name="dof_armature_1" type="continuous">
        <origin xyz="-5.55112e-17 0.0508 2.77556e-17" rpy="2.76164e-15 -1.18866 3.14159" />
        <axis xyz="0 -1 0" />
        <parent link="armature_nichibo_01_predeterminado__fillet5" />
        <child link="nichibo__motor_back_01_predeterminado__fillet20" />
    </joint>
    <joint name="dof_armature_2" type="continuous">
        <origin xyz="2.498e-16 0.0508 7.77156e-16" rpy="0 1.5708 -3.14159" />
        <axis xyz="0 -1 0" />
        <parent link="armature_nichibo_01_predeterminado__fillet5_1" />
        <child link="nichibo__motor_back_01_predeterminado__fillet20_1" />
    </joint>
    <joint name="dof_gear" type="continuous">
        <origin xyz="-0.019295 0.025 1.11022e-16" rpy="3.14159 -3.06541e-16 1.5708" />
        <axis xyz="-1 0 0" />
        <parent link="gear_idler_holder_1" />
        <child link="default_10" />
    </joint>
    <joint name="dof_gear_1" type="continuous">
        <origin xyz="2.10942e-15 0.05 0.015" rpy="-8.04912e-16 -1.80809e-15 2.00995e-15" />
        <axis xyz="-1 0 0" />
        <parent link="gear_idle_holder_2" />
        <child link="default_14" />
    </joint>
    <joint name="dof_idler" type="continuous">
        <origin xyz="-0.656 0.015 0.015" rpy="-1.60982e-15 -2.67834e-16 1.82046e-15" />
        <axis xyz="-1 0 0" />
        <parent link="gear_idle_holder_3" />
        <child link="default_2" />
        <mimic offset="0" multiplier="-1" joint="dof_idler_2" />
    </joint>
    <joint name="dof_idler_1" type="continuous">
        <origin xyz="-0.019295 0.025 5.55112e-17" rpy="3.14159 3.12054e-16 1.5708" />
        <axis xyz="-1 0 0" />
        <parent link="gear_idler_holder" />
        <child link="default_12" />
    </joint>
    <joint name="dof_idler_2" type="continuous">
        <origin xyz="1.11022e-16 0.015 0.015" rpy="-2.77556e-17 -1.83795e-15 1.46704e-16" />
        <axis xyz="-1 0 0" />
        <parent link="gear_idle_holder_3" />
        <child link="default_16" />
    </joint>
    <joint name="dof_lead_nut_joint" type="fixed">
        <origin xyz="-0.278324 -0.011844 -0.031800" rpy="1.570800 1.405720 -1.570800" />
        <axis xyz="-0 -0 -1" />
        <parent link="z_attachment" />
        <child link="dof_lead_nut" />
        <limit effort="1" velocity="1" lower="-0.102627" upper="0.147373" />
    </joint>
    <joint name="dof_lead_nut_1" type="fixed">
        <origin xyz="0 0 0" rpy="0 -0 0" />
        <axis xyz="-0 -0 -1" />
        <parent link="dof_lead_nut" />
        <child link="8x270x1_5_lead_screw" />
    </joint>
    <joint name="dof_linear_bearing" type="prismatic">
        <origin xyz="0.626 0.0 0.055974" rpy="0 1.5708 4.76769e-15" />
        <axis xyz="-1 0 0" />
        <parent link="8x1040_guide_rod_3" />
        <child link="default_1" />
        <limit effort="1" velocity="1" lower="0.0" upper="1.06" />
    </joint>
    <joint name="dof_linear_bearing_1" type="fixed">
        <origin xyz="0.0 0.0 0.055974" rpy="0 1.5708 4.52911e-15" />
        <axis xyz="-1 0 0" />
        <parent link="8x1040_guide_rod_3" />
        <child link="default_13" />
        <limit effort="1" velocity="1" lower="0.0" upper="1.06" />
    </joint>
    <joint name="dof_linear_bearing_2" type="prismatic">
        <origin xyz="1.66533e-16 -1.11022e-16 -0.345194" rpy="0 -1.5708 1.5708" />
        <axis xyz="-1 0 0" />
        <parent link="8x600_guiding_rod_1" />
        <child link="default_9" />
        <limit effort="1" velocity="1" lower="-0.306944" upper="0.313056" />
    </joint>
    <joint name="dof_linear_bearing_loop_closure" type="prismatic">
        <origin xyz="0.159049 0 0" rpy="0 1.5708 -6.56511e-16" />
        <axis xyz="-0 -0 -1" />
        <parent link="default_17" />
        <child link="z_axis_end_piece__1__loop_closure" />
        <limit effort="1" velocity="1" lower="-0.101665" upper="0.148335" />
    </joint>
    <joint name="fastened_1" type="fixed">
        <origin xyz="-0.011 0.000416995 -0.003" rpy="-3.63485e-24 -1.57772e-30 -1.02171e-23" />
        <axis xyz="-0 -0 1" />
        <parent link="z_axis_end_piece" />
        <child link="z_axis_carriage_piece__1_" />
    </joint>
    <joint name="fastened_1_1" type="fixed">
        <origin xyz="0 -0.00015 0" rpy="3.14159 0.752378 -5.57059e-16" />
        <axis xyz="-0 -1 -0" />
        <parent link="nichibo__motor_back_01_predeterminado__fillet20_2" />
        <child link="__motor_assy_nichibo_md5_2445___jameco__232047__1__2" />
    </joint>
    <joint name="fastened_1_2" type="fixed">
        <origin xyz="0.00553514 0.02435 1.11022e-16" rpy="-1.59595e-16 1.18774e-16 1.77702e-16" />
        <axis xyz="-0 -0 1" />
        <parent link="guide_holder_2" />
        <child link="x_carriage__1_" />
    </joint>
    <joint name="fastened_1_3" type="fixed">
        <origin xyz="6.93889e-18 -0.00015 0" rpy="3.14159 0.752378 -5.25599e-17" />
        <axis xyz="-0 -1 -0" />
        <parent link="nichibo__motor_back_01_predeterminado__fillet20" />
        <child link="__motor_assy_nichibo_md5_2445___jameco__232047__1_" />
    </joint>
    <joint name="fastened_1_4" type="fixed">
        <origin xyz="0.642 1.11022e-16 0.02" rpy="-3.14159 -1.69124e-15 -3.14159" />
        <axis xyz="-0 -1.47544e-16 -1" />
        <parent link="default_6" />
        <child link="default_8" />
    </joint>
    <joint name="fastened_1_5" type="fixed">
        <origin xyz="-1.11022e-16 0.01 -0.006" rpy="-1.96908e-31 9.55165e-18 -9.69667e-17" />
        <axis xyz="-0 -0 1" />
        <parent link="guide_holder_5" />
        <child link="y_carriage__1_" />
    </joint>
    <joint name="fastened_1_6" type="fixed">
        <origin xyz="-1.11022e-16 -0.00015 1.38778e-16" rpy="-3.14159 0.752378 8.60338e-16" />
        <axis xyz="-0 -1 -0" />
        <parent link="nichibo__motor_back_01_predeterminado__fillet20_1" />
        <child link="__motor_assy_nichibo_md5_2445___jameco__232047__1__1" />
    </joint>
    <joint name="fastened_1_loop_closure" type="fixed">
        <origin xyz="0.006 5.55112e-17 0.02" rpy="-3.14159 1.45698e-15 -2.0664e-16" />
        <axis xyz="-0 -1.47544e-16 -1" />
        <parent link="default_5" />
        <child link="hfsb5_2020_618__1__loop_closure" />
    </joint>
    <joint name="fastened_2" type="fixed">
        <origin xyz="-0.03 -3.88578e-16 3.88578e-16" rpy="-1.5708 -2.22045e-16 1.5708" />
        <axis xyz="1 1.22465e-16 -0" />
        <parent link="frame_holder" />
        <child link="default_3" />
    </joint>
    <joint name="fastened_2_1" type="fixed">
        <origin xyz="1.11022e-16 6.07153e-18 0.005" rpy="1.5708 1.11022e-16 1.5708" />
        <axis xyz="-0 1 -0" />
        <parent link="motor_holder_2" />
        <child link="nichibo_motor_housing_01_predeterminado__cut_extrude10_2" />
    </joint>
    <joint name="fastened_2_2" type="fixed">
        <origin xyz="0.3 1.11022e-16 -0.004" rpy="0 1.5708 3.14159" />
        <axis xyz="-1 -0 -0" />
        <parent link="default_7" />
        <child link="default_6" />
    </joint>
    <joint name="fastened_2_3" type="fixed">
        <origin xyz="0.3 -1.11022e-16 -0.652" rpy="0 -1.5708 -6.80012e-16" />
        <axis xyz="-1 -0 -0" />
        <parent link="default_7" />
        <child link="default_5" />
    </joint>
    <joint name="fastened_2_4" type="fixed">
        <origin xyz="0.648 1.66533e-16 -1.33227e-15" rpy="0 -1.5708 4.45858e-16" />
        <axis xyz="0 0 1" />
        <parent link="default_6" />
        <child link="default_4" />
    </joint>
    <joint name="fastened_2_5" type="fixed">
        <origin xyz="0.656 -1.88738e-15 1.08247e-15" rpy="-1.5708 -2.22045e-16 1.5708" />
        <axis xyz="1 1.22465e-16 -0" />
        <parent link="frame_holder" />
        <child link="default_15" />
    </joint>
    <joint name="fastened_2_loop_closure" type="fixed">
        <origin xyz="-5.55112e-17 5.55112e-17 -1.11022e-16" rpy="0 -1.5708 3.14159" />
        <axis xyz="0 0 1" />
        <parent link="default_5" />
        <child link="hfsb5_2020_300__1__loop_closure" />
    </joint>
    <joint name="fastened_2_loop_closure_1" type="fixed">
        <origin xyz="-0.03 5.55112e-17 5.55112e-17" rpy="-1.5708 -2.22045e-16 -1.5708" />
        <axis xyz="1 1.22465e-16 -0" />
        <parent link="frame_holder_1" />
        <child link="lmut8__4__loop_closure" />
    </joint>
    <joint name="fix_bed_to_origin" type="fixed">
        <origin xyz="-1.57772e-30 0 4.33065e-30" rpy="-1.04257e-42 0 0" />
        <axis xyz="0 0 -1" />
        <parent link="root" />
        <child link="crop_bed__1__1" />
    </joint>
    <joint name="fix_control_box" type="fixed">
        <origin xyz="0.145 0 0.01" rpy="-2.93547e-16 -1.33169e-16 -1.5708" />
        <axis xyz="0 0 -1" />
        <parent link="default_7" />
        <child link="control_box" />
    </joint>
    <joint name="fix_control_box_lid" type="fixed">
        <origin xyz="-5.55112e-17 5.55112e-17 0.035" rpy="-5.54668e-30 -9.3215e-32 1.91052e-31" />
        <axis xyz="0 0 -1" />
        <parent link="control_box" />
        <child link="control_box_lid" />
    </joint>
    <joint name="fix_coupler" type="fixed">
        <origin xyz="0 0 0.034" rpy="0 -1.5708 1.5708" />
        <axis xyz="1 0 0" />
        <parent link="8x270x1_5_lead_screw" />
        <child link="default__cplcn20_8_8_b_2" />
    </joint>
    <joint name="fix_coupler_1" type="fixed">
        <origin xyz="0 2.77556e-17 0" rpy="0 -1.5708 3.14159" />
        <axis xyz="-0 -0 1" />
        <parent link="default__cplcn20_8_8_b" />
        <child link="shaft_extension" />
    </joint>
    <joint name="fix_coupler_2" type="fixed">
        <origin xyz="-0.0001 -1.11022e-16 2.77556e-17" rpy="0 -1.5708 -3.59974e-17" />
        <axis xyz="0 0 1" />
        <parent link="default__cplcn20_8_8_b_1" />
        <child link="shaft_extension_1" />
    </joint>
    <joint name="fix_end_piece_joint" type="fixed">
        <origin xyz="-0.023 0.000155697 -0.0155488" rpy="9.37784e-25 2.22045e-16 3.14159" />
        <axis xyz="-0 1 -0" />
        <parent link="z_axis_end_piece" />
        <child link="fix_end_piece_2" />
        <limit effort="1" velocity="1" lower="-10000" upper="10000" />
    </joint>
    <joint name="fix_end_piece_1_joint" type="fixed">
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
