PontshoMbizo/js06-gantry-robot/gantry-cli/boot_art.py

"""
Boot splash art, lifted cell-for-cell from the design (screen 01).

Each row is a list of (column, text, role); roles are theme.py names.
The art is the Onshape model drawn in block characters; the startup
checks are drawn to its right at RIGHT_COL.
"""

RIGHT_COL = 79
TOP_ROW = 3

ART = [
    [(9, '▄▄', 'ay')],
    [(8, '▐██▌', 'ay')],
    [(8, '│║║│', 'am')],
    [(8, '│║║│', 'am'), (12, '▄██▄', 'ao')],
    [(8, '│║║│╱', 'am'), (13, '█▌', 'ag')],
    [(8, '│║║│', 'am'), (13, '█▌', 'ag')],
    [(7, '▐████▌', 'ao'), (13, '█▌', 'ag')],
    [(5, '╱╱', 'am'), (7, '▐████▌', 'ao'), (13, '█▌', 'ag')],
    [(2, '▄██▄', 'ao'), (7, '╱│║║│', 'am'), (13, '█▌', 'ag')],
    [(3, '█▌', 'ag'), (5, '╱╱', 'am'), (8, '│║║│', 'am'), (13, '█▌', 'ag')],
    [(3, '█▌', 'ag'), (8, '│║║│', 'am'), (13, '█▌', 'ag')],
    [(3, '█▌', 'ag'), (8, '│║║│', 'am'), (12, '▟█▙', 'ab'), (15, '═══════════════════════════════════════════════════════════', 'am'), (74, '▟█▙', 'ab')],
    [(3, '█▌', 'ag'), (8, '│║║│', 'am'), (13, '·', 'as'), (16, '·', 'as'), (17, '▄██▄', 'ap'), (22, '·', 'as'), (25, '·', 'as'), (26, '▄██▄', 'ap'), (31, '·', 'as'), (34, '·', 'as'), (35, '╻', 'ap'), (37, '╻', 'ap'), (39, '╻', 'ap'), (40, '·', 'as'), (41, '╻', 'ap'), (43, '╻', 'ap'), (45, '╻', 'ap'), (46, '·', 'as'), (47, '╻', 'ap'), (49, '╻', 'ap'), (52, '·', 'as'), (55, '▲', 'ap'), (58, '·', 'as'), (61, '▲', 'ap'), (64, '·', 'as'), (67, '▲', 'ap'), (70, '·', 'as'), (73, '▲', 'ap'), (75, '│', 'aw')],
    [(3, '█▌', 'ag'), (8, '▝██▘', 'ay'), (14, '▀████▀', 'ap'), (20, '·', 'as'), (23, '▀████▀', 'ap'), (29, '·', 'as'), (32, '·', 'as'), (33, '┃', 'ap'), (35, '┃', 'ap'), (37, '┃', 'ap'), (38, '·', 'as'), (39, '┃', 'ap'), (41, '┃', 'ap'), (43, '┃', 'ap'), (44, '·', 'as'), (45, '┃', 'ap'), (47, '┃', 'ap'), (50, '·', 'as'), (52, '▟█▙', 'ap'), (56, '·', 'as'), (58, '▟█▙', 'ap'), (62, '·', 'as'), (64, '▟█▙', 'ap'), (68, '·', 'as'), (70, '▟█▙', 'ap'), (75, '│', 'aw')],
    [(3, '█▌', 'ag'), (7, '╱', 'aw'), (9, '▼', 'ac'), (12, '·', 'as'), (15, '·', 'as'), (18, '·', 'as'), (21, '·', 'as'), (24, '·', 'as'), (27, '·', 'as'), (30, '·', 'as'), (31, '▪', 'au'), (33, '▪', 'au'), (35, '▪', 'au'), (36, '·', 'as'), (37, '▪', 'au'), (39, '▪', 'au'), (41, '▪', 'au'), (42, '·', 'as'), (43, '▪', 'au'), (45, '▪', 'au'), (48, '·', 'as'), (51, '·', 'as'), (54, '·', 'as'), (57, '·', 'as'), (60, '·', 'as'), (63, '·', 'as'), (66, '·', 'as'), (69, '╱', 'aw'), (75, '│', 'aw')],
    [(3, '█▌', 'ag'), (5, '╱', 'aw'), (7, '·', 'as'), (10, '·', 'as'), (11, '▄██▄', 'ap'), (16, '·', 'as'), (19, '·', 'as'), (20, '▄██▄', 'ap'), (25, '·', 'as'), (28, '·', 'as'), (29, '╻', 'ap'), (31, '╻', 'ap'), (33, '╻', 'ap'), (34, '·', 'as'), (35, '╻', 'ap'), (37, '╻', 'ap'), (39, '╻', 'ap'), (40, '·', 'as'), (41, '╻', 'ap'), (43, '╻', 'ap'), (46, '·', 'as'), (49, '▲', 'ap'), (52, '·', 'as'), (55, '▲', 'ap'), (58, '·', 'as'), (61, '▲', 'ap'), (64, '▄', 'ay'), (67, '▲', 'ap'), (75, '│', 'aw')],
    [(2, '▟█▙', 'ab'), (5, '══════════════════════════════════════════════════════════', 'am'), (63, '▟█▙', 'ab'), (75, '│', 'aw')],
    [(3, '│░░░░░░░░░░░░░░░░░░░░░░░░░░░░░░░░░░░░░░░░░░░░░░', 'aw'), (50, '┌───────┐', 'ag'), (59, '░░░░░│', 'aw'), (73, '╱', 'aw')],
    [(3, '├───────────────────────────', 'aw'), (31, '◦', 'ag'), (32, '──────────────────', 'aw'), (50, '│', 'ag'), (52, '●', 'ay'), (54, '●', 'ar'), (56, '●', 'ap'), (58, '│', 'ag'), (59, '─────┤', 'aw'), (71, '╱', 'aw')],
    [(3, '│░░░░░░░░░░░░░░░░░░░░░░░░░░░░░░░░░░░░░░░░░░░░░░', 'aw'), (50, '│', 'ag'), (52, '▐███▌', 'ag'), (58, '│', 'ag'), (59, '░░░░░│', 'aw'), (69, '╱', 'aw')],
    [(3, '│░░░░░░░░░░░░░░░░░░░░░░░░░░░░░░░░░░░░░░░░░░░░░░', 'aw'), (50, '└───────┘', 'ag'), (59, '░░░░░│', 'aw'), (67, '╱', 'aw')],
    [(3, '└────────────────────────────────────────────────────────────┘╱', 'aw')],
]
