PontshoMbizo/js06-gantry-robot/(commit log)

2026-11-06 Gantry robot for automatic weed removal: CLI, ESP32-C3 firmware and simulations
    Operator software for the Raspberry Pi Zero W, ESP32-C3 motion firmware (v2.5)
    with a host-side firmware simulator, the axis controller design simulation and
    the ROS 2 digital twin, with a README covering design, findings and
    recommendations.
    Claude-Session: https://claude.ai/code/session_01YB9b5pjMhMzLnehoFL3ufZ
    [ARMATURE_NICHIBO_01_Predeterminado__Fillet5.stl, BokChoy__12_.stl, COIL_01_Predeterminado__Fillet6.stl, Default.stl, Default_1.stl, Default_2.stl, Default_3.stl, Default_4.stl]
2026-11-06 README: resize images, crop CAD render so both pictures match
    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
2026-11-06 README: drop unrelated test-bed photo, show the stitched bed alone
    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
2026-11-06 README: show four raw sweep frames beside the stitched bed image
    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
